craftvia/craftvia-makercard-s/LICENSES/README.md

# CraftVia Licensing

Copyright (c) 2026 Kohei Ikeda.

CraftVia uses separate licenses for hardware, software, documentation, and brand assets. A license that applies to one category does not grant rights in another category.

## License map

| Material | License |
| --- | --- |
| Hardware design sources and manufacturing files | [CERN Open Hardware Licence Version 2 - Permissive](CERN-OHL-P-2.0.txt) (`CERN-OHL-P-2.0`) |
| Software source code | [Apache License 2.0](Apache-2.0.txt) (`Apache-2.0`) |
| Documentation, diagrams, and other identified documentation content | [Creative Commons Attribution 4.0 International](CC-BY-4.0.txt) (`CC-BY-4.0`) |
| CraftVia name, logos, wordmarks, symbols, and other brand assets | All rights reserved; see the [CraftVia Trademark Policy](TRADEMARK_POLICY.md) |

The complete license texts and brand policy are stored in this directory. The repository root `LICENSE` contains the primary license for GitHub detection and convenient access. When a repository contains more than one category of material, this document defines the category boundaries.

## Scope rules

1. A file-specific license notice or SPDX identifier takes priority over this document.
2. Third-party material remains subject to its original license and attribution notice.
3. Hardware includes schematics, PCB layouts, editable EDA sources, Gerber data, BOMs, placement data, mechanical design files, and other files explicitly identified as hardware design material.
4. Software includes source code, scripts, firmware, libraries, tests, and build configuration explicitly identified as software.
5. Documentation includes prose, specifications, tutorials, and diagrams, unless a file-specific notice says otherwise.
6. Generated output is governed according to the source material and any notice included with the output.
7. The open licenses do not grant permission to use CraftVia brand assets. Descriptive references and compatibility statements are governed by the CraftVia Trademark Policy.

## Notices to use in repositories

### Hardware

```text
Copyright (c) 2026 Kohei Ikeda.
SPDX-License-Identifier: CERN-OHL-P-2.0
```

### Software

```text
Copyright (c) 2026 Kohei Ikeda.
SPDX-License-Identifier: Apache-2.0
```

### Documentation

```text
Copyright (c) 2026 Kohei Ikeda.
SPDX-License-Identifier: CC-BY-4.0
```

## Attribution for documentation

A suitable attribution is:

> CraftVia documentation, copyright Kohei Ikeda, licensed under CC BY 4.0.

Where practical, link “CraftVia documentation” to the original material and “CC BY 4.0” to <https://creativecommons.org/licenses/by/4.0/>. Indicate if changes were made.

## No endorsement

Permission to use, copy, modify, or manufacture material under an open license does not make a product or service official, approved, certified, or endorsed by CraftVia or Kohei Ikeda.

This document is an English-language project policy and is the authoritative version. Any translation is provided for convenience.
