craftvia/craftvia-makercard-s/LICENSES/TRADEMARK_POLICY.ja.md

# CraftVia商標ポリシー（参考訳）

発効日：2026年10月1日

CraftViaの名称、ロゴ、ワードマーク、シンボル、製品ファミリーを示す標章、ビジュアルアイデンティティその他の識別力を有するブランド資産（以下、総称して「CraftVia標章」）は、Kohei Ikedaが所有します。本ポリシーで明示的に許諾していない権利は、すべて留保されます。

英語版の [`TRADEMARK_POLICY.md`](TRADEMARK_POLICY.md) が正本です。この日本語版は理解の便宜のための参考訳です。本ポリシーは、CraftViaのハードウェア、ソフトウェアおよび文書に適用されるオープンライセンスとは別のものです。これらのライセンスは商標権を許諾しません。

## 個別許可を必要としない利用

次の目的では、事実に即した通常の文字表記として「CraftVia」を使用できます。

- CraftViaプロジェクトまたは公式資料への言及
- 製品がCraftViaと互換性を持つこと、CraftVia向けであること、またはCraftViaを基にしていることの表示
- CraftViaへのリンクまたはプロジェクトについての議論
- 改変していない公式設計ファイル、または特定の公式Releaseどおりに製造したハードウェアの正確な識別
- 報道、論評、教育、研究、レビューにおける正確な説明

これらの利用において、実際には存在しない後援、認証、推奨、公式性または提携関係を示唆してはいけません。

## 事前の書面による許可を必要とする利用

次の利用には、Kohei Ikedaによる事前の書面許可が必要です。

- CraftViaのロゴ、シンボルまたは意匠化されたワードマークの使用。ただし、未改変の公式文書を複製する場合、または後述する許可済みの非商用利用のため、未改変の公式ハードウェアReleaseにあらかじめ埋め込まれた標章を複製する場合を除く
- 会社、組織、製品、サービス、ドメイン、SNSアカウント、イベントまたは商品名へのCraftVia標章の使用
- 改変設計、第三者製品、fork、サービスまたは組織を、CraftViaの「公式」「認証」「承認」「公認」と表示すること
- CraftVia標章を付したハードウェアの販売申出、販売、商用頒布、または有料の製品・サービスへの組み込み。未改変の公式製造データに埋め込まれた標章を含む場合も対象とする
- 広告または包装において、第三者製品自身の名称・標章よりCraftVia標章を目立たせること
- CraftVia標章と混同されるおそれのあるロゴまたは標章の作成

## 公式設計データから製造するハードウェア

適用されるオープンハードウェアライセンスに従い、ハードウェアを製造、改変、販売できます。ただし、その権利にCraftVia標章の使用権は含まれず、第三者製造品をCraftViaが製造、品質管理、保証、認証または販売した製品であるかのように表示することはできません。

公式ReleaseのGerberその他製造データにCraftVia標章が含まれている場合、個人利用、組織内利用、教育、研究、評価その他の非商用利用のため、その特定Releaseを改変せず製造する範囲に限り、個別許可なく埋め込まれた標章を複製できます。依頼者の指示に基づいて受託製造だけを行う第三者の基板製造サービスへ発注する場合も含みます。ただし、当該製造サービスがCraftViaブランドを付した自社のカタログ製品として宣伝または販売申出を行わないことを条件とします。

CraftVia標章を付したハードウェアの販売申出、販売、商用頒布、または有料の製品・サービスへの組み込みには、事前の書面許可が必要です。未改変の公式製造データに標章が埋め込まれている場合も、この要件が適用されます。

この商標上の要件はCraftVia標章だけに適用されます。CraftVia標章を削除し、適用されるライセンス表示および著作権表示を保持し、CraftVia公式製品として表示しない場合、適用されるオープンハードウェアライセンスに基づくハードウェア設計の製造、改変、商用販売を制限するものではありません。事実に即した通常文字による互換性表示または帰属表示は引き続き使用できます。

改変設計、および商標使用の書面許可を得ていない商用製品では、合理的に可能な範囲でCraftViaロゴその他の出所表示を削除してください。次のような事実に即した通常文字の表示は可能です。

> Based on the CraftVia Core-S G031 v1 rev0 design. Modified and manufactured independently by [name]. Not an official CraftVia product.

## 互換性表示

「compatible with CraftVia」「for use with CraftVia」「based on CraftVia」などの表示は、正確である場合に使用できます。CraftVia名称の使用は互換性の説明に必要な範囲にとどめ、自社製品・組織の名称をより目立たせてください。

## 改変・登録の禁止

CraftViaロゴを改変または他の標章と結合しないでください。また、CraftVia標章またはこれと混同されるおそれのある標章を、商標、会社名、ドメイン、アカウント名その他の識別子として登録または登録申請しないでください。

## 表示例

合理的に可能な場合、次の表示を記載してください。

> CraftVia is a trademark of Kohei Ikeda. This product/project is independently produced and is not endorsed by or affiliated with CraftVia.

## 許可申請

本ポリシーの範囲外の利用申請には、申請者、利用する標章、利用目的、地域および期間を記載し、CraftVia公式Webサイトで公開する連絡方法からお問い合わせください。

許可には追加の書面条件が付される場合があり、その条件または本ポリシーに違反した場合は撤回されることがあります。

## 変更および質問

本ポリシーは更新される場合があります。CraftVia公式ドキュメントリポジトリで公開される版を正本とします。本ポリシーは実務上の利用許諾を示すものであり、適用法令上認められる権利を放棄するものではありません。
