craftvia/craftvia-makercard-s/docs/images/makercard-s-v1-rev0-back.webp

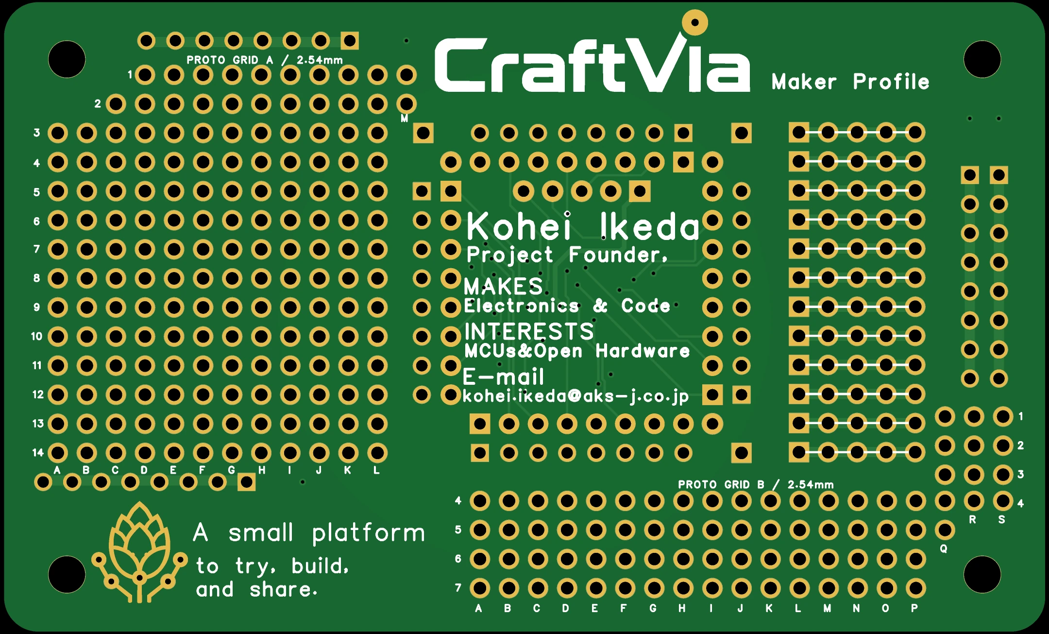
docs/images/makercard-s-v1-rev0-back.webp
