craftvia/craftvia-makercard-s/docs/images/makercard-s-v1-rev0-front.webp

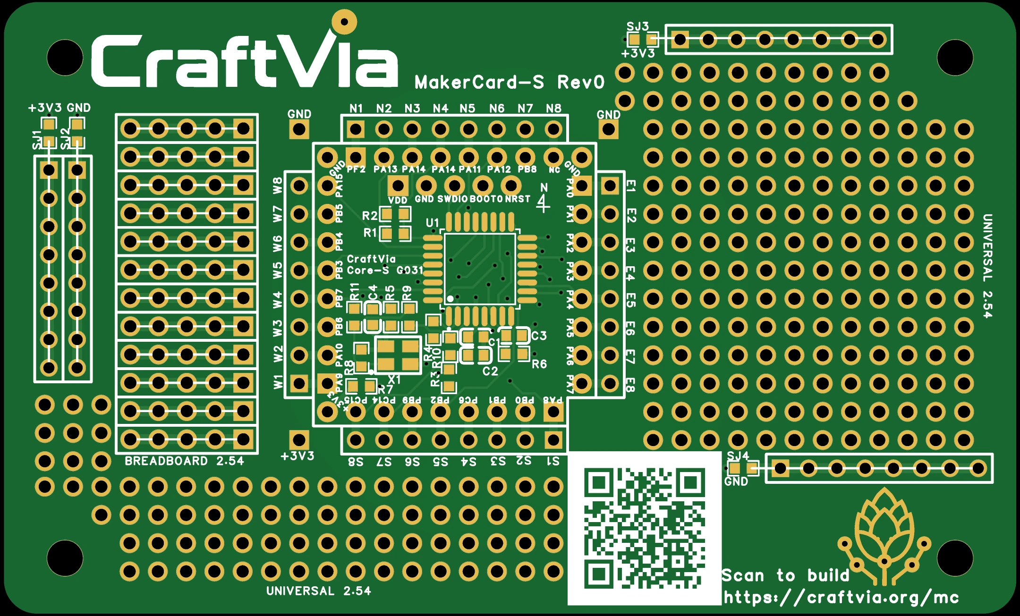
docs/images/makercard-s-v1-rev0-front.webp
