craftvia/craftvia-makercard-s/RELEASE_NOTES.ja.md

# CraftVia MakerCard-S v1 Rev0 ハードウェアリリース

## リリース状態

- リビジョン: Rev0
- リリース日: 2026-09-30
- 状態: 初回試作PCB製造向けに凍結済み（FROZEN）
- 用途: Rev0エンジニアリング試作。一般量産向けリリースではありません
- CAD: EasyEDA v3.2.149.88089769
- 編集可能な正本ソース: `source/CraftVia-MakerCard-S-v1-Rev0.eprj2`
- PCB製造アップロード用正本: `fabrication/Gerber_PCB1_2026-09-30.zip`

このリリースは、2026-09-30にEasyEDAで開いたプロジェクトと照合済みです。プロジェクト、回路図ページ、PCB文書のUUIDは、凍結済みソースパッケージと一致しています。エクスポートしたBOM、CPL、回路図PDF、PCB PDFについても、開いている設計と照合しています。

## リリース判定

以下の発注・実装条件を満たすことを前提として、本パッケージは初回Rev0 PCB試作発注に使用できます。

- PCB厳密DRC: PASS、エラー0件
- 回路図DRC: Fatal 0件、Error 0件、Warning 1件
- 残る回路図警告は致命的ではありません。EasyEDAのブリッジ結果からは警告件数のみ確認でき、UI上の詳細メッセージは取得できませんが、PCBの接続またはクリアランスエラーに対応するものではありません。
- Gerber ZIP整合性: PASS
- 基板: 91.0 mm x 55.0 mm、角丸半径3.0 mm、銅箔4層
- 取付穴: 3.2 mm NPTH穴4か所
- 確認済みPCB内容: 部品・機能フットプリント56個、配線線分482本、ビア36個、銅箔ポア2個、ネット59個

## リリース内容

| パス | 用途 |
| --- | --- |
| `source/CraftVia-MakerCard-S-v1-Rev0.eprj2` | 編集可能なEasyEDAプロジェクト正本 |
| `source/ProPrj_CraftVia-MakerCard-S-v1-Rev0_2026-09-30.epro` | ポータブルEasyEDAプロジェクトアーカイブ |
| `fabrication/Gerber_PCB1_2026-09-30.zip` | PCB製造用正本パッケージ |
| `assembly/BOM_Board1_PCB1_2026-09-30.csv` | 実装対象部品の正本BOM |
| `assembly/PickAndPlace_PCB1_2026_09_30.csv` | 基板全体の座標エクスポート。実装サービスへアップロードする前に要フィルター |
| `assembly/PCB_PCB1_2026-09-30.pdf` | PCB、BOM、実装・層構成の参照用エクスポート |
| `docs/SCH_MakerCard-S-Rev0_2026-09-30.pdf` | 人が読むための回路図参照資料 |
| `SHA256SUMS.txt` | SHA-256整合性マニフェスト |

## PCB製造パッケージ

`fabrication/Gerber_PCB1_2026-09-30.zip`を、そのままPCBメーカーへアップロードしてください。内容の編集や再圧縮はしないでください。

ZIPには次のデータが含まれます。

- Top、Inner 1、Inner 2、Bottomの各銅箔層
- TopおよびBottomソルダーマスク
- TopおよびBottomシルクスクリーン
- Topペーストマスク
- Top組立図層および文書層
- 基板外形
- NPTH、部品用PTH、ビア用PTHのドリルデータ

Bottom面にSMT部品がないため、Bottomペーストファイルはありません。

発注前に、この正確なZIPをJLCDFMまたは基板メーカーのGerberプレビューへ読み込み、次を確認してください。

- 91.0 mm x 55.0 mm、角丸半径3.0 mmの角丸長方形外形
- 銅箔4層
- 3.2 mmの取付穴4か所が、`(5.5, 5.0)`、`(85.5, 5.0)`、`(5.5, 50.0)`、`(85.5, 50.0)` mmのNPTHとして認識されること
- 大きな試作領域およびブレークアウト穴の配列がPTHとして認識されること
- Top/Bottomシルク、QRコード、ソルダーマスク開口、基板文字が判読でき、向きも正しいこと
- ドリル位置ずれ、重複ドリル、予期しない長穴の警告がないこと

ZIPには`Drill_PTH_Through.DRL`と`Drill_PTH_Through_Via.DRL`の両方が含まれます。ドリルファイルを個別に選んでアップロードせず、完全なZIPを使用してメーカーのプレビューを確認してください。

発注時に選択するメーカーの層構成を正本とします。後続リリースで制御された層構成を指定しない限り、標準的な4層FR-4試作構成を使用してください。

## 実装対象

BOMは15行、実装対象の部品番号は16個です。

`C1, C2, C3, J1, J2, J3, J4, J5, J6, J7, R1, R2, R3, R7, R10, U1`

次の電気的オプション部品は、Rev0では意図的にDNPです。

`C4, R4, R5, R6, R8, R9, R11, X1`

次のテストポイントはPCB機能であり、BOMの実装対象ではありません。

`TP1, TP2, TP3, TP4, TP5`

次のブレークアウト、試作領域、電源レール接続用フットプリントは、実装BOMから意図的に除外しています。

`BB1-BB12, BBP1-BBP4, J8-J14, SJ1-SJ4`

### ピックアンドプレースに関する警告

`assembly/PickAndPlace_PCB1_2026_09_30.csv`は、56個すべての部品番号を含む未フィルターの基板エクスポートです。BOMの16部品番号に加えて、DNP、テストポイント、試作機能の40行が含まれています。

- PCB製造のみの場合、Gerber発注には影響しません。
- 一括実装を依頼する場合、インポート結果を確認せずにCPLをそのままアップロードしないでください。
- CPLを正本BOMの16部品番号に絞り込むか、実装業者がBOMとCPLの部品番号の積集合のみを使用し、それ以外の行をすべてDNPに設定することを確認してください。
- 実装状態については、未フィルターCPLおよび実装PDF上の赤いX印よりBOMを優先します。

J1-J7はスルーホールピンヘッダーです。通常のSMT実装では取り付けられません。THT実装サービスを明示的に選択するか、実装後に手作業で取り付けてください。J1-J4は仕入先参照`C49256`を使用します。購入前に、角ピン寸法、嵌合部ピン長、インシュレーター高さが、意図するCore-S/Station-Sの機械的積層と一致することを確認してください。J5-J7は`C81276`を使用し、公称嵌合部ピン長は6 mm、インシュレーター高さは2.5 mmです。

## データシートおよび電気的構成

- U1: STM32G031K8T6、LQFP32、7 mm x 7 mm、0.8 mmピッチ。パッケージおよびピン割り当ては凍結済みフットプリントと一致
- 入力電源: 3.3 V
- C1/C3: 100 nF、C2: 4.7 µF。STM32G031の電源デカップリング指針と整合
- R7: 実装、0 Ω。`VDD_CORE`を給電
- R3: 実装、0 ΩのGPIOリンク
- R10: 実装、0 Ω
- 外部8 MHz発振器オプション: DNP。内部HSIが既定クロック源
- ASEDVNオプションフットプリントのピン割り当て: 1=`OSC_EN`、2=GND、3=`OSC_OUT`、4=`VDD_OSC`。発振器データシートと整合
- PA14はSWCLKとBOOT0で共用。ファームウェアおよびStation-Sの選択・分離状態は、実装されたリンク状態と一致させること
- 試作用電源レールは、対応する`SJ1-SJ4`を意図的にブリッジしない限り分離状態

## 既知の文書上の注意

回路図PDFには、過去のラベル`SCHEMATIC DRAFT`および`DESIGN NOTES - NOT RELEASED FOR FABRICATION`が残っています。この凍結フォルダにおいて、回路図PDFは回路レビュー用の参照資料に限られ、製造正本ではありません。このREADMEとSHA-256マニフェストがRev0のリリース状態を定義し、Gerber ZIPのみがPCB製造正本です。

実装PDFはEasyEDAの複数ページ参照用エクスポートです。赤いX印は除外・DNP対象を示しますが、BOMの代わりにはなりません。実装対象についてはBOM CSVを正本とします。

後続リビジョンまたは文書のみを整理した再パッケージでは、過去のドラフト表記を削除し、それ以外は変更していないソースから回路図PDFを再生成してください。

## 初品確認

1. 製造品を受け入れる前に、91.0 mm x 55.0 mmの外形、4つの角穴、QRコード、両面の文字を目視確認する。
2. 部品実装前に、試作領域の各列および4本の電源レールについて導通と絶縁を確認する。
3. `SJ1-SJ4`が開放であり、製造時の状態で各レール対が絶縁されていることを確認する。
4. 他のCraftVia基板と接続する前に、J1-J7の向きと導通を確認する。
5. 電流制限した3.3 V電源から給電し、`VDD_CORE`とGND間に短絡がないことを確認する。
6. U1のVDD/VDDAで3.3 Vを測定し、想定されるアイドル電流であることを確認する。
7. PA13/SWDIO、PA14/SWCLK、PF2/NRSTを介してSWDを確認した後、共用PA14ネットワーク上のBOOT動作を確認する。
8. 導通検査治具を使用し、N/E/S/Wブレークアウトの割り当てとブレッドボード・試作領域のネットを確認する。
9. 初回の内部HSI立ち上げでは、X1とそのオプション回路をDNPのままにする。

## 変更管理と整合性

発注前に`SHA256SUMS.txt`に記載されたすべてのファイルを検証してください。このリリースを発注に使用した後は、`v1-rev0`タグまたはそのGitHub Releaseアセットに含まれるファイルを上書きしないでください。電気設計、フットプリント、配線、アートワーク、シルク、実装対象の変更には新しいリビジョンが必要です。文書のみの訂正は、タグを移動または置換せず、後続コミットで行ってください。
