craftvia/craftvia-makercard-s/(list of files, drawings)

Other design files:
source/ProPrj_CraftVia-MakerCard-S-v1-Rev0_2026-09-30.epro
